techfoundrynz/wheelie_fun_display/pcb/README.md

# PCB designs

Editable board projects and their wiring guides:

- [GUITION 4.3-inch CAN breakout](guition-43/README.md): CAN transceiver, display expansion socket and six-pin vehicle connector.

Mechanical case and mount downloads are in [CAD](../cad/README.md).
