techfoundrynz/wheelie_fun_display/cad/guition-43/rear-casing.step

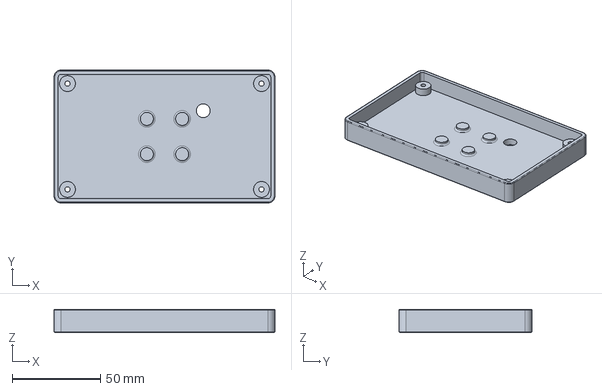
[picture p17: CAD file, 2026-11-12]
cad/guition-43/rear-casing.step
125.3 x 75.3 x 13.2 mm
