techfoundrynz/wheelie_fun_display/cad/waveshare-206/rubber-liner.step

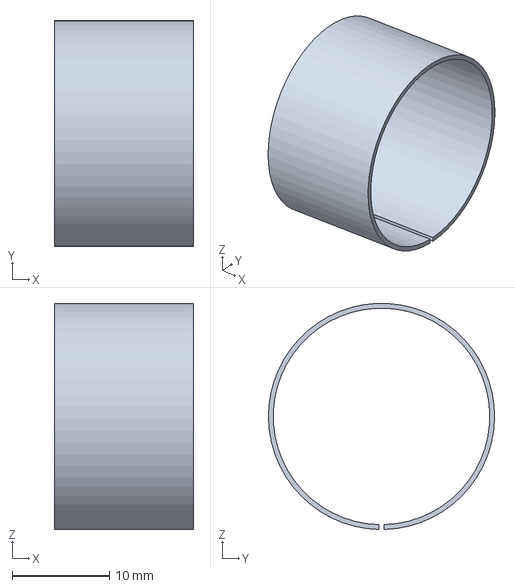
[picture p18: CAD file, 2026-11-08]
cad/waveshare-206/rubber-liner.step
14.3 x 23.2 x 23.2 mm
