techfoundrynz/wheelie_fun_display/cad/guition-43/cable-grommet.step

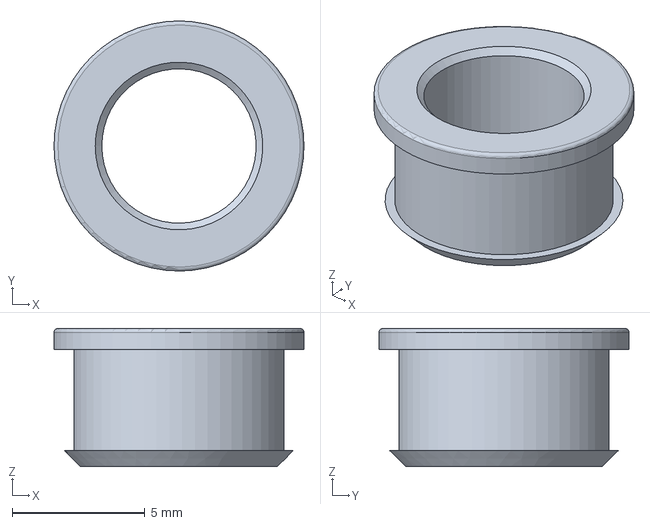
[picture p19: CAD file, 2026-11-12]
cad/guition-43/cable-grommet.step
9.40 x 9.40 x 5.20 mm
