techfoundrynz/wheelie_fun_display/cad/waveshare-206/rear-casing.step

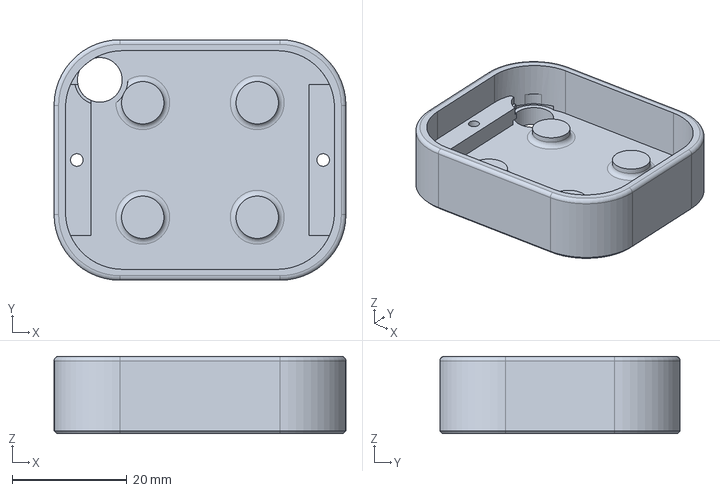
[picture p20: CAD file, 2026-11-08]
cad/waveshare-206/rear-casing.step
51.0 x 42.0 x 13.5 mm
