techfoundrynz/wheelie_fun_display/cad/waveshare-206/upper-saddle.step

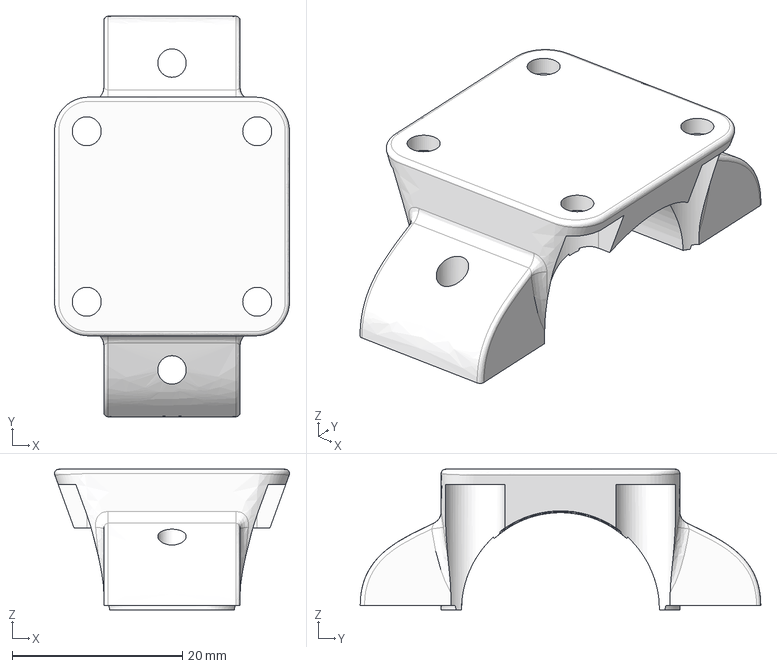
[picture p21: CAD file, 2026-11-08]
cad/waveshare-206/upper-saddle.step
27.6 x 47.0 x 16.5 mm
