techfoundrynz/wheelie_fun_display/cad/guition-43/lower-clamp-cap.step

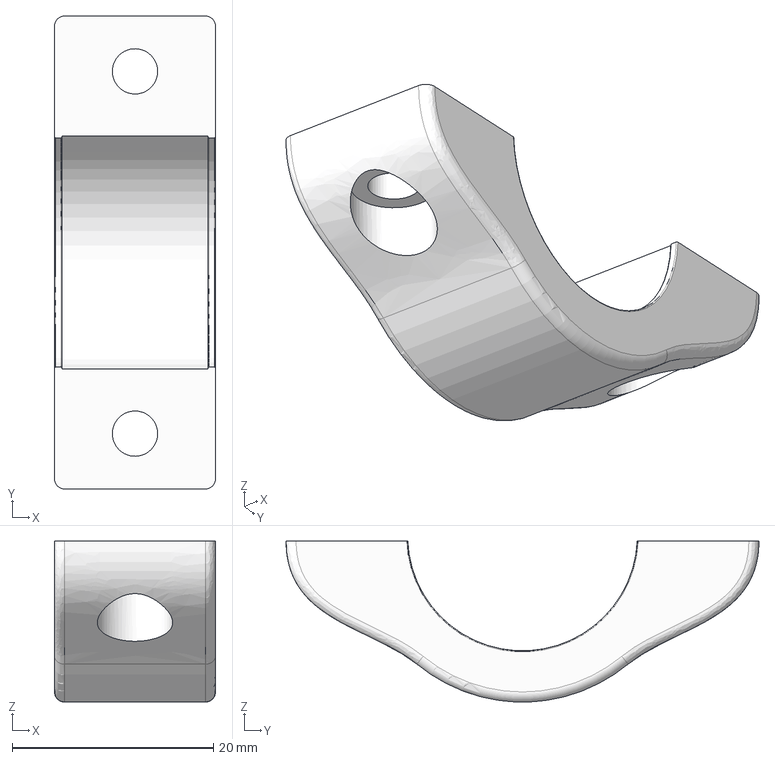
[picture p22: CAD file, 2026-11-08]
cad/guition-43/lower-clamp-cap.step
16.0 x 47.0 x 16.0 mm
