techfoundrynz/wheelie_fun_display/(list of files, cad)

Other CAD files:
cad/guition-43/rubber-liner.step
cad/waveshare-206/lower-clamp-cap.step
cad/guition-43/upper-saddle.step
cad/waveshare-206/cable-grommet.step
cad/wheelie-fun-display-mounts.f3d
