techfoundrynz/wheelie_fun_display/docs/site-maintenance.md

# Releases, validation and Pages

Contributor instructions for publishing firmware and maintaining the help site. For on-device updates, see [updates and maintenance](maintenance.md).

## Automatic releases and PR previews

Increase `[common].custom_firmware_version` in `platformio.ini`, commit and push to `main`. CI compares the configured version with the highest semantic version actually published on GitHub, including prereleases. An unpublished newer version stays eligible on subsequent pushes, so a failed build followed by a formatting or code fix can still release the same version. The first version is eligible when no releases exist. Already published versions, downgrades and build-metadata-only changes do not trigger another release. Draft releases and tags without a published release do not count as publication; failure to query GitHub stops release detection.

The pipeline runs formatting, sanitizer tests and native UI checks, builds every supported `default_envs` target once, then tests the browser simulator and installer using those firmware artifacts. Only after those stages succeed does it create `v<version>` at that commit and publish the OTA/factory images, notices and source references. An existing tag must identify the same commit; published assets are never replaced. Re-running the same published commit leaves its release unchanged.

For an explicit manual publication, run **Actions > CI, firmware and previews > Run workflow** on `main` with **publish_release** enabled. A manual run without that option validates only. Pushed version tags also work, but the tag must match the configuration. Prerelease versions are marked as prereleases on GitHub; separate OTA channels are not implemented.

PRs run the same validation and produce a hosted simulator link and browser-test gallery in one updated bot comment and the publication run summary. Each URL includes the PR number and exact head revision. Preview frames isolate PR scripts from the parent and disable hardware APIs. Superseded builds are skipped, and closing a PR removes its preview and updates the comment.

A separate trusted publisher runs after successful CI, verifies artifact provenance, refreshes only the tested installer's release catalog and firmware files from published releases and deploys Pages. It executes only default-branch publication code, never PR publication scripts. Generated site content is retained on the `gh-pages` storage branch so production updates preserve open PR previews. The first successful `main` pipeline initializes that storage automatically; PR publication cannot replace an uninitialized production site. Downloadable site and firmware artifacts remain available as a fallback.

## Release artifacts

Build the supported environments before packaging:

```sh
pio run
python scripts/check_sdkconfig.py --all
python -m pip install -r requirements-release.txt
python scripts/package_release.py
```

Packaging writes OTA applications `.pio/releases/<environment>.bin`, complete USB images `<environment>-factory.bin`, `manifest.json`, `licenses.zip` and `source-references.json`. The notices archive preserves the project, font, icon and bundled component licenses. Source references record the application repository/commit and pinned Slint tag/commit; local uncommitted changes are marked explicitly. The supported list comes from `default_envs`; removed board images are not carried forward. CI builds that supported list at the configured version and passes the verified artifacts to the release stage.

The complete USB image is merged from the build's actual bootloader, partition-table, OTA initialization and application offsets; it is not interchangeable with an OTA application image. USB installation can reset NVS settings.

Review the version, board identity, sizes and hashes before publishing. App slots are 7 MiB each. A newly booted image is accepted only after initialization and ten seconds of a functioning UI loop; an early failure leaves rollback available.

## Hardware acceptance

A successful build and simulator check do not establish radio or wired interoperability. For a release, record the exact board, controller firmware and phone/app used, then exercise:

- Cold boot, all four orientations, corner-safe layout and touch alignment.
- Settings scrolling, PIN entry, locked timeout and wake-contact consumption.
- Disconnect/reconnect, upstream encrypted pairing and changed/removed local PINs.
- CAN/UART operation with the actual transceiver/wiring and controller discovery.
- Phone proxy behavior, CAN forwarding, MTU differences, sustained traffic and lease release.
- Wi-Fi/OTA success, failure, cancellation and first-boot acceptance.

Track remaining hardware work in [TODO](../TODO.md). Record repeatable performance measurements in [performance notes](performance.md); a startup sample does not establish a sustained frame rate.

## Documentation and Pages

The help site is a TypeScript TanStack Start app. See [help-site development](../website/README.md) for local Vite preview, pnpm setup, Oxlint and Oxfmt. The simulator and flasher are React routes; firmware catalogs, WASM and screenshots remain generated build inputs.

CI builds the browser simulator, renders documentation pictures from that current shared Slint UI, then assembles and tests the site. Screenshots are generated artifacts under `.cache/pages/docs-images`; do not check them in or regenerate them before committing.

To reproduce the complete Pages build locally:

```sh
# Install the Node.js 24 / pnpm documentation app once.
corepack pnpm --dir website install --frozen-lockfile
python -m pip install -r requirements-docs.txt -r simulator/requirements-browser-test.txt
python -m playwright install chromium
python scripts/build_web_simulator.py --output .cache/pages/site/simulator
python scripts/generate_docs_screenshots.py --site .cache/pages/site
python scripts/build_docs.py --output .cache/pages/site
python scripts/build_flash_site.py --site .cache/pages/site --github-release
python tests/flasher_browser_test.py --site .cache/pages/site
python tests/simulator_browser_test.py --site .cache/pages/site
python scripts/package_browser_results.py --site .cache/pages/site
python tests/docs_browser_test.py --site .cache/pages/site
```

The [browser installer](https://techfoundrynz.github.io/wheelie_fun_display/install/) uses pinned ESP Web Tools and same-origin, SHA256-verified release images. After successful CI and any release publication, the trusted Pages publisher refreshes the installer from published images without rebuilding the simulator. Before the first release, the installer lists supported boards and reports that firmware is unavailable. For local packaging checks, use `--release-dir .pio/releases` instead of `--github-release`; that preview is clearly labelled unpublished.

The [interactive simulator](../simulator/) is the clean end-user preview. The separate [CI browser evidence gallery](../ci/) contains touchscreen checks and their captured images. Browser checks cover root and project-subpath hosting, navigation, search, touch, rotation, PIN entry, telemetry and responsive layout. Screenshots support visual review; they are not pixel-baseline comparisons or real-device acceptance.

Preview the generated site through a local HTTP server. Both the downloadable site artifact and GitHub Pages include the simulator and separate CI gallery. Generated HTML and screenshots are build outputs, not a second hand-edited copy of the source.

## Test discovery

TypeScript tests for the help site use Vitest. Add `*.test.ts` or `*.test.tsx` files under `website/src` or `website/plugins`. Run `corepack pnpm test:docs` once, or `corepack pnpm test:docs:watch` while editing. The Pages workflow runs the same Vitest suite before building the site. Browser acceptance checks continue to use Playwright against the built app.

CI runs the same framework entry points used locally:

```sh
python -m unittest discover -s tests -p '*_tests.py' -v
corepack pnpm test:docs
node --test tests/*_tests.cjs
cargo test --locked --manifest-path simulator/Cargo.toml
ctest --test-dir .cache/host-tests --output-on-failure
```

Add Python unit tests as `tests/*_tests.py` and Node suites as `tests/*_tests.cjs`. Cargo automatically discovers `#[test]` cases under `simulator/tests/`; display scenarios share the supported viewport list and launch isolated fixture processes to avoid sharing Slint platform state. Register C++ suites with CTest in `tests/CMakeLists.txt`. New test cases do not require workflow edits. Browser acceptance checks run in the Pages build after its simulator and installer artifacts exist.

The P4 board profile explicitly selects `build.toolchain = riscv32-esp`. A pre-build hook applies it immediately before framework build environments are created, and the matching compiler package is pinned in the common configuration. This compensates for espressif32 8.0.0's incomplete MCU architecture table; do not patch the locally installed platform builder.
