techfoundrynz/wheelie_fun_display/firmware/main/board_guition_p4.cpp

#include "board.hpp"
#include "boards/guition_st7701_init.hpp"
#include "driver/gpio.h"
#include "driver/i2c_master.h"
#include "driver/ledc.h"
#include "eh_host_core.h"
#include "eh_host_mcu_transport.h"
#include "eh_host_mcu_transport_init_event.h"
#include "esp_cache.h"
#include "esp_check.h"
#include "esp_hosted_bt_host_stack.h"
#include "esp_lcd_mipi_dsi.h"
#include "esp_lcd_panel_io.h"
#include "esp_lcd_touch_gt911.h"
#include "esp_ldo_regulator.h"
#include "esp_timer.h"
#include "freertos/task.h"
#include "render_profile.hpp"
#include <algorithm>
#include <atomic>
#include <cstring>

namespace board
{
namespace
{

esp_ldo_channel_handle_t phy_supply;
esp_lcd_dsi_bus_handle_t dsi;
esp_lcd_panel_io_handle_t command_io;
uint16_t *framebuffers[2]{};
unsigned back = 1;
SemaphoreHandle_t refreshed;
std::atomic<uint32_t> refresh_generation{0};
uint32_t submitted_refresh = 0;
bool frame_pending = false;
bool has_frame = false;
int display_core = 0;

static_assert(std::atomic<uint32_t>::is_always_lock_free);

bool brightness_ready = false;

bool IRAM_ATTR refresh_done(esp_lcd_panel_handle_t, esp_lcd_dpi_panel_event_data_t *, void *) {
  refresh_generation.fetch_add(1, std::memory_order_release);
  BaseType_t wake = pdFALSE;
  xSemaphoreGiveFromISR(refreshed, &wake);
  return wake == pdTRUE;
}

void reset_pin(int pin, unsigned low_ms, unsigned settle_ms) {
  gpio_config_t config{};
  config.pin_bit_mask = 1ULL << pin;
  config.mode = GPIO_MODE_OUTPUT;
  ESP_ERROR_CHECK(gpio_config(&config));
  ESP_ERROR_CHECK(gpio_set_level(static_cast<gpio_num_t>(pin), 0));
  vTaskDelay(pdMS_TO_TICKS(low_ms));
  ESP_ERROR_CHECK(gpio_set_level(static_cast<gpio_num_t>(pin), 1));
  vTaskDelay(pdMS_TO_TICKS(settle_ms));
}

void init_brightness() {
  ledc_timer_config_t timer{};
  timer.speed_mode = LEDC_LOW_SPEED_MODE;
  timer.duty_resolution = LEDC_TIMER_10_BIT;
  timer.timer_num = LEDC_TIMER_0;
  timer.freq_hz = 5000;
  timer.clk_cfg = LEDC_AUTO_CLK;
  ESP_ERROR_CHECK(ledc_timer_config(&timer));
  ledc_channel_config_t channel{};
  channel.gpio_num = DISP_BL;
  channel.speed_mode = LEDC_LOW_SPEED_MODE;
  channel.channel = LEDC_CHANNEL_0;
  channel.timer_sel = LEDC_TIMER_0;
  channel.duty = 0;
  ESP_ERROR_CHECK(ledc_channel_config(&channel));
  brightness_ready = true;
}

} // namespace

Display init() {
  display_core = xPortGetCoreID();
  init_brightness();
  Display display;
  refreshed = xSemaphoreCreateBinary();
  configASSERT(refreshed);

  esp_ldo_channel_config_t power{};
  power.chan_id = 3;
  power.voltage_mv = 2500;
  ESP_ERROR_CHECK(esp_ldo_acquire_channel(&power, &phy_supply));

  esp_lcd_dsi_bus_config_t bus{};
  bus.bus_id = 0;
  bus.num_data_lanes = DISP_DSI_LANES;
  bus.phy_clk_src = MIPI_DSI_PHY_PLLREF_CLK_SRC_DEFAULT;
  bus.lane_bit_rate_mbps = DISP_DSI_MBPS;
  ESP_ERROR_CHECK(esp_lcd_new_dsi_bus(&bus, &dsi));
  esp_lcd_dbi_io_config_t control{};
  control.virtual_channel = 0;
  control.lcd_cmd_bits = 8;
  control.lcd_param_bits = 8;
  ESP_ERROR_CHECK(esp_lcd_new_panel_io_dbi(dsi, &control, &command_io));

  esp_lcd_dpi_panel_config_t dpi{};
  dpi.virtual_channel = 0;
  dpi.dpi_clk_src = MIPI_DSI_DPI_CLK_SRC_DEFAULT;
  dpi.dpi_clock_freq_mhz = DISP_DPI_CLOCK_MHZ;
  dpi.in_color_format = LCD_COLOR_FMT_RGB565;
  dpi.out_color_format = LCD_COLOR_FMT_RGB565;
  dpi.num_fbs = 2;
  dpi.video_timing.h_size = panel_width;
  dpi.video_timing.v_size = panel_height;
  dpi.video_timing.hsync_pulse_width = 12;
  dpi.video_timing.hsync_back_porch = 42;
  dpi.video_timing.hsync_front_porch = 42;
  dpi.video_timing.vsync_pulse_width = 2;
  dpi.video_timing.vsync_back_porch = 8;
  dpi.video_timing.vsync_front_porch = 166;
  ESP_ERROR_CHECK(esp_lcd_new_panel_dpi(dsi, &dpi, &display.panel));
  reset_pin(DISP_RST, 20, 120);
  for (const auto &entry : board_p4_panel_init_cmds) {
    ESP_ERROR_CHECK(esp_lcd_panel_io_tx_param(command_io, entry.cmd, entry.data, entry.len));
    if (entry.delay_ms)
      vTaskDelay(pdMS_TO_TICKS(entry.delay_ms));
  }
  void *first_framebuffer = nullptr, *second_framebuffer = nullptr;
  ESP_ERROR_CHECK(esp_lcd_dpi_panel_get_frame_buffer(display.panel, 2, &first_framebuffer, &second_framebuffer));
  framebuffers[0] = static_cast<uint16_t *>(first_framebuffer);
  framebuffers[1] = static_cast<uint16_t *>(second_framebuffer);
  const size_t bytes = size_t(panel_width) * panel_height * sizeof(uint16_t);
  for (auto *framebuffer : framebuffers) {
    std::memset(framebuffer, 0, bytes);
    ESP_ERROR_CHECK(esp_cache_msync(framebuffer, bytes, ESP_CACHE_MSYNC_FLAG_DIR_C2M));
  }
  esp_lcd_dpi_panel_event_callbacks_t callbacks{};
  callbacks.on_frame_buf_complete = refresh_done;
  ESP_ERROR_CHECK(esp_lcd_dpi_panel_register_event_callbacks(display.panel, &callbacks, nullptr));
  ESP_ERROR_CHECK(esp_lcd_panel_init(display.panel));

  i2c_master_bus_config_t i2c_config{};
  i2c_config.i2c_port = I2C_NUM_0;
  i2c_config.sda_io_num = static_cast<gpio_num_t>(I2C_SDA);
  i2c_config.scl_io_num = static_cast<gpio_num_t>(I2C_SCL);
  i2c_config.clk_source = I2C_CLK_SRC_DEFAULT;
  i2c_config.glitch_ignore_cnt = 7;
  i2c_config.flags.enable_internal_pullup = true;
  i2c_master_bus_handle_t i2c;
  ESP_ERROR_CHECK(i2c_new_master_bus(&i2c_config, &i2c));
  reset_pin(TP_RST, 10, 50);
  int address = ESP_LCD_TOUCH_IO_I2C_GT911_ADDRESS;
  if (i2c_master_probe(i2c, address, 100) != ESP_OK)
    address = ESP_LCD_TOUCH_IO_I2C_GT911_ADDRESS_BACKUP;
  ESP_ERROR_CHECK(i2c_master_probe(i2c, address, 100));
  esp_lcd_panel_io_i2c_config_t touch_io{};
  touch_io.dev_addr = address;
  touch_io.control_phase_bytes = 1;
  touch_io.lcd_cmd_bits = 16;
  touch_io.flags.disable_control_phase = true;
  touch_io.scl_speed_hz = 400000;
  esp_lcd_panel_io_handle_t touch_control;
  ESP_ERROR_CHECK(esp_lcd_new_panel_io_i2c(i2c, &touch_io, &touch_control));
  esp_lcd_touch_config_t touch{};
  touch.x_max = panel_width;
  touch.y_max = panel_height;
  touch.rst_gpio_num = GPIO_NUM_NC; // Reset completed before probing the strapped address.
  touch.int_gpio_num = GPIO_NUM_NC;
  ESP_ERROR_CHECK(esp_lcd_touch_new_i2c_gt911(touch_control, &touch, &display.touch));
  brightness(70);
  return display;
}

void brightness(int percent) {
  if (!brightness_ready)
    return;
  ESP_ERROR_CHECK(ledc_set_duty(LEDC_LOW_SPEED_MODE, LEDC_CHANNEL_0, std::clamp(percent, 0, 100) * 1023 / 100));
  ESP_ERROR_CHECK(ledc_update_duty(LEDC_LOW_SPEED_MODE, LEDC_CHANNEL_0));
}

esp_err_t init_radio() {
  ESP_RETURN_ON_ERROR(eh_host_init(nullptr), "radio", "Hosted initialization failed");
  ESP_RETURN_ON_ERROR(eh_host_connect_to_slave(), "radio", "C6 transport unavailable");
  esp_hosted_bt_host_stack_cfg_t config{};
  config.stack = ESP_HOSTED_BT_HOST_STACK_NIMBLE;
  // Before v2.5.2, the companion enables Bluetooth at startup and lacks init/enable RPCs.
  const auto companion_version = eh_host_mcu_transport_get_fw_version();
  config.bring_up_controller = !(companion_version >= 0x00000006 && companion_version < 0x00020502);
  config.controller_ready_timeout_ms = EH_BT_CTRL_DEFAULT_READY_TIMEOUT_MS;
  return esp_hosted_bt_host_stack_setup(&config);
}

bool radio_tx_ready() {
  return eh_host_mcu_transport_is_tx_ready() > 0;
}

esp_err_t wait_frame() {
  // UI and DMA ISR share a core: the next ISR sees the published buffer index.
  configASSERT(xPortGetCoreID() == display_core);
  const TickType_t deadline = xTaskGetTickCount() + pdMS_TO_TICKS(500);
  while (frame_pending && refresh_generation.load(std::memory_order_acquire) == submitted_refresh) {
    if (int32_t(deadline - xTaskGetTickCount()) <= 0)
      return ESP_ERR_TIMEOUT;
    xSemaphoreTake(refreshed, pdMS_TO_TICKS(50));
  }
  frame_pending = false;
  return ESP_OK;
}

esp_err_t acquire_frame(uint16_t **pixels) {
  if (!pixels)
    return ESP_ERR_INVALID_ARG;
#if WFD_RENDER_PROFILE
  const auto started = esp_timer_get_time();
#endif
  ESP_RETURN_ON_ERROR(wait_frame(), "display", "Framebuffer handoff timed out");
#if WFD_RENDER_PROFILE
  render_profile::last_refresh_us = esp_timer_get_time() - started;
#endif
  *pixels = framebuffers[back];
  return ESP_OK;
}

const uint16_t *last_frame() {
  return has_frame ? framebuffers[back ^ 1] : nullptr;
}

esp_err_t present_frame(Display &display, FrameRect region) {
#if WFD_RENDER_PROFILE
  const auto started = esp_timer_get_time();
#endif
  ESP_RETURN_ON_ERROR(esp_lcd_panel_draw_bitmap(display.panel, region.x, region.y, region.x + region.width,
                                                region.y + region.height, framebuffers[back]),
                      "display", "Framebuffer presentation failed");
#if WFD_RENDER_PROFILE
  render_profile::last_submit_us = esp_timer_get_time() - started;
#endif
  submitted_refresh = refresh_generation.load(std::memory_order_acquire);
  frame_pending = true;
  has_frame = true;
  back ^= 1;
  return ESP_OK;
}

} // namespace board
