techfoundrynz/wheelie_fun_display/firmware/main/wired_transport.hpp

#pragma once
#include "transport.hpp"

namespace transport
{

bool wired_update_valid(uint32_t session);

void wired_update_reply(uint8_t peer, uint32_t session, std::span<const uint8_t> payload);

Interface &wired_backend(Kind kind);

bool wired_available(Kind kind);

void wired_proxy_ownership(bool owned, uint32_t epoch);

bool wired_send_proxy_fragment(std::span<const uint8_t> bytes, uint32_t epoch);

bool wired_proxy_drained(uint32_t epoch);

void wired_reset_proxy_link();

} // namespace transport
