techfoundrynz/wheelie_fun_display/tests/transport_tests.cpp

#include "bike/can_bridge.hpp"
#include "bike/can_packet.hpp"
#include "bike/configuration_write.hpp"
#include "bike/controller_discovery.hpp"
#include "bike/security_policy.hpp"
#include <cstdlib>
#include <iostream>
#include <numeric>
#include <vector>
#define CHECK(c)                                                                                                       \
  do {                                                                                                                 \
    if (!(c)) {                                                                                                        \
      std::cerr << __LINE__ << ": " #c "\n";                                                                           \
      std::exit(1);                                                                                                    \
    }                                                                                                                  \
  } while (0)
using Bytes = std::vector<uint8_t>;

Bytes firmware(uint8_t uuid, uint8_t type = 0, uint8_t configs = 1) {
  Bytes bytes{0, 6, 6, 'V', 'E', 'S', 'C', 0};
  for (int i = 0; i < 12; ++i)
    bytes.push_back(uuid + i);
  bytes.insert(bytes.end(), {0, 0, type, configs});
  return bytes;
}

Bytes wfb_sample() {
  Bytes bytes(48);
  bytes[0] = 36;
  bytes[1] = 102;
  bytes[2] = 10;
  bytes[3] = 1;
  return bytes;
}

Bytes wheel_e_info(std::string_view name = "Wheel-E") {
  Bytes bytes(61);
  bytes[0] = 36;
  bytes[1] = 101;
  bytes[2] = 0;
  bytes[3] = 2;
  std::copy_n(name.begin(), std::min<size_t>(name.size(), 20), bytes.begin() + 5);
  bytes[25] = 1;
  bytes[26] = 3;
  bytes[54] = 0x27;
  bytes[55] = 0x10;
  return bytes;
}

Bytes wheel_e_sample() {
  Bytes bytes(28);
  bytes[0] = 36;
  bytes[1] = 101;
  bytes[2] = 33;
  bytes[3] = 1;
  bytes[5] = 0x0a;
  bytes[7] = 2;
  return bytes;
}

Bytes setup_sample() {
  Bytes bytes(56);
  bytes[0] = 47;
  return bytes;
}

void codec_tests() {
  for (size_t size :
       {size_t(1), size_t(6), size_t(7), size_t(255), size_t(256), size_t(259), size_t(260), bike::max_payload}) {
    Bytes payload(size);
    std::iota(payload.begin(), payload.end(), uint8_t(0));
    std::vector<bike::CanFrame> frames;
    CHECK(bike::send_can_packet(payload, 12, 254, true, [&](auto frame) {
      frames.push_back(frame);
      return true;
    }));
    bike::CanReassembler decoder;
    std::span<const uint8_t> result;
    uint64_t now = 1;
    for (auto frame : frames)
      result = decoder.feed(frame, 254, 12, now++);
    CHECK(Bytes(result.begin(), result.end()) == payload);
    CHECK(frames.back().id == ((size <= 6 ? 8u : 7u) << 8 | 254));
    if (size > 6) {
      CHECK(frames.front().data[0] == 0 && frames.front().size == 8);
      auto bad = frames.back();
      bad.data[5] ^= 1;
      for (size_t i = 0; i + 1 < frames.size(); ++i)
        decoder.feed(frames[i], 254, 12, now++);
      CHECK(decoder.feed(bad, 254, 12, now++).empty());
      // Missing/reordered fragments and timeout cannot deliver stale payloads.
      for (size_t i = 1; i < frames.size(); ++i)
        CHECK(decoder.feed(frames[i], 254, 12, now++).empty());
      decoder.feed(frames.front(), 254, 12, 1000);
      for (size_t i = 1; i < frames.size(); ++i)
        CHECK(decoder.feed(frames[i], 254, 12, 1600 + i).empty());
    }
    for (auto frame : frames)
      CHECK(decoder.feed(frame, 253, 12, now++).empty());
    for (auto frame : frames)
      CHECK(decoder.feed(frame, 254, 11, now++).empty());
  }
  const Bytes command{36, 102, 12, 1};
  std::vector<bike::CanFrame> frames;
  CHECK(bike::send_can_packet(command, 254, 5, false, [&](auto frame) {
    frames.push_back(frame);
    return true;
  }));
  CHECK(frames.size() == 1 && frames[0].id == 0x805 && frames[0].data[0] == 254 && frames[0].data[1] == 0);
  CHECK(std::equal(command.begin(), command.end(), frames[0].data.begin() + 2));
  bike::CanReassembler decoder;
  CHECK(decoder.feed(frames[0], 5, 254, 1).empty()); // Requests are never interpreted as replies.
  CHECK(!bike::send_can_packet(command, 255, 5, false, [](auto) { return true; }));
  CHECK(!bike::send_can_packet(command, 5, 5, false, [](auto) { return true; }));
  CHECK(!bike::send_can_packet(Bytes(bike::max_payload + 1), 254, 5, false, [](auto) { return true; }));
  CHECK(!bike::send_can_packet(Bytes(1024), 254, 5, false, [](auto) { return false; }));
}

void bridge_tests() {
  bike::ProxyAuthorization authorization{false, true, 1, 1, 1};
  CHECK(authorization.allows(false, false));
  authorization.pin_required = true;
  CHECK(!authorization.allows(false, false));
  CHECK(!authorization.allows(true, false));
  CHECK(authorization.allows(true, true));
  ++authorization.revision; // New/changed bike PIN immediately rejects the old phone bond.
  CHECK(!authorization.allows(true, true));
  authorization.applied_revision = authorization.revision;
  CHECK(!authorization.allows(true, true)); // A previously encrypted connection is still stale.
  authorization.connection_revision = authorization.revision;
  CHECK(authorization.allows(true, true));
  authorization.pin_known = false; // Boot with hashed PIN: user must unlock before BLE can use that PIN.
  CHECK(!authorization.allows(true, true));
  authorization.pin_known = true;
  authorization.pin_required = false;
  ++authorization.revision;
  authorization.applied_revision = authorization.revision;
  CHECK(!authorization.allows(true, true)); // Removing a PIN also invalidates the old connection.
  authorization.connection_revision = authorization.revision;
  CHECK(authorization.allows(false, false));
  CHECK(bike::valid_proxy_name("WB Disp"));
  CHECK(!bike::valid_proxy_name(""));
  CHECK(!bike::valid_proxy_name("bad\nname"));
  CHECK(!bike::valid_proxy_name(std::string(30, 'x')));
  const Bytes forward{34, 42, 36, 101, 12, 1};
  const auto request = bike::can_bridge_request(forward, 254);
  CHECK(request.operation == bike::BridgeOperation::Forward && request.destination == 42);
  CHECK(Bytes(request.payload.begin(), request.payload.end()) == Bytes({36, 101, 12, 1}));
  for (const uint8_t opcode : {0, 157}) {
    const Bytes directed{34, 42, opcode};
    const auto forwarded = bike::can_bridge_request(directed, 254);
    CHECK(forwarded.operation == bike::BridgeOperation::Forward && forwarded.destination == 42);
    CHECK(forwarded.payload.size() == 1 && forwarded.payload[0] == opcode);
  }
  CHECK(bike::can_bridge_request(Bytes{0}, 254).operation == bike::BridgeOperation::Firmware);
  CHECK(bike::can_bridge_request(Bytes{62}, 254).operation == bike::BridgeOperation::Scan);
  CHECK(bike::can_bridge_request(Bytes{47}, 254).operation == bike::BridgeOperation::Unsupported);
  CHECK(bike::can_bridge_request(Bytes{34, 254, 0}, 254).operation == bike::BridgeOperation::Unsupported);
  CHECK(bike::can_bridge_request(Bytes{34, 255, 0}, 254).operation == bike::BridgeOperation::Unsupported);
  CHECK(bike::can_bridge_request({}, 254).operation == bike::BridgeOperation::Unsupported);
  CHECK(bike::can_bridge_request(Bytes{34, 42}, 254).operation == bike::BridgeOperation::Unsupported);
  std::array<uint8_t, 12> uuid{};
  std::array<uint8_t, 96> firmware{};
  const auto length = bike::can_bridge_firmware(firmware, uuid);
  CHECK(length > 30 && firmware[0] == 0);
  const auto end = std::find(firmware.begin() + 3, firmware.end(), 0);
  const auto extra = size_t(end - firmware.begin()) + 13;
  CHECK(firmware[extra + 2] == 2 && firmware[extra + 3] == 0); // Generic adapter, no motor/package identity.
  CHECK(bike::can_bridge_firmware(std::span(firmware).first(10), uuid) == 0);
  const auto branded_length = bike::can_bridge_firmware(firmware, uuid, "waveshare_esp32s3_206", "0.1.3");
  CHECK(branded_length > 0);
  size_t position = 3;
  auto string_at = [&](std::span<const uint8_t> data) {
    const auto first = position;
    while (position < data.size() && data[position])
      ++position;
    CHECK(position < data.size());
    const std::string value(reinterpret_cast<const char *>(data.data() + first), position - first);
    ++position;
    return value;
  };
  const auto identity = std::span(firmware).first(branded_length);
  CHECK(identity[1] == bike::bridge_protocol_major && identity[2] == bike::bridge_protocol_minor);
  CHECK(string_at(identity) == "waveshare_esp32s3_206");
  CHECK(std::equal(uuid.begin(), uuid.end(), identity.begin() + position));
  position += uuid.size();
  CHECK(identity[position++] == 0 && identity[position++] == 0);
  CHECK(identity[position++] == 2);
  for (int flag = 0; flag < 5; ++flag)
    CHECK(identity[position++] == 0);
  CHECK(string_at(identity) == "Wheelie Fun Display v0.1.3");
  CHECK(position + 4 == branded_length);
  CHECK(bike::can_bridge_request(Bytes{157}, 254).operation == bike::BridgeOperation::FirmwareInfo);
  CHECK(bike::can_bridge_request(Bytes{30}, 254).operation == bike::BridgeOperation::Ignore);
  std::array<uint8_t, 128> info{};
  auto info_length = bike::can_bridge_firmware_info(info, "0123456789abcdef-dirty", "");
  CHECK(info_length == 28 && info[0] == 157 && info[1] == bike::bridge_protocol_major &&
        info[2] == bike::bridge_protocol_minor && info[3] == 0);
  position = 4;
  CHECK(string_at(std::span(info).first(info_length)) == "0123456789abcdef-dirty");
  CHECK(string_at(std::span(info).first(info_length)).empty() && position == info_length);
  CHECK(bike::can_bridge_firmware_info(std::span(info).first(info_length - 1), "0123456789abcdef-dirty") == 0);
  info_length = bike::can_bridge_firmware_info(info, std::string(90, 'a'), std::string(90, 'b'));
  CHECK(info_length == 98 && info[50] == 0 && info[97] == 0);
  CHECK(bike::can_bridge_firmware_info(info, "") == 6);

  for (const bool extended : {false, true}) {
    const uint32_t identifier = extended ? 0x1fffffffu : 0x7ffu;
    Bytes raw{85,
              uint8_t(identifier >> 24),
              uint8_t(identifier >> 16),
              uint8_t(identifier >> 8),
              uint8_t(identifier),
              uint8_t(extended)};
    for (unsigned dlc = 0; dlc <= 8; ++dlc) {
      const auto parsed = bike::can_bridge_request(raw, 254);
      CHECK(parsed.operation == bike::BridgeOperation::RawFrame);
      CHECK(parsed.frame.id == identifier && parsed.frame.extended == extended && !parsed.frame.remote);
      CHECK(parsed.frame.size == dlc);
      CHECK(std::equal(raw.begin() + 6, raw.end(), parsed.frame.data.begin()));
      CHECK(bike::valid_can_data_frame(parsed.frame));
      raw.push_back(uint8_t(dlc));
    }
    CHECK(bike::can_bridge_request(raw, 254).operation == bike::BridgeOperation::Invalid);
  }
  for (const Bytes &malformed : {Bytes{85}, Bytes{85, 0, 0, 0, 0}, Bytes{85, 0, 0, 0, 0, 2}, Bytes{85, 0, 0, 8, 0, 0},
                                 Bytes{85, 0x20, 0, 0, 0, 1}})
    CHECK(bike::can_bridge_request(malformed, 254).operation == bike::BridgeOperation::Invalid);
  bike::CanFrame invalid;
  invalid.remote = true;
  CHECK(!bike::valid_can_data_frame(invalid));
  invalid.remote = false;
  invalid.size = 9;
  CHECK(!bike::valid_can_data_frame(invalid));
  std::vector<bike::CanFrame> frames;
  CHECK(bike::send_can_packet(Bytes{0, 6, 6}, 42, 254, true, [&](auto frame) {
    frames.push_back(frame);
    return true;
  }));
  bike::CanReassembler decoder;
  const auto payload = decoder.feed(frames.front(), 254, -1, 1);
  CHECK(Bytes(payload.begin(), payload.end()) == Bytes({0, 6, 6}) && decoder.sender() == 42);
}

void discovery_tests() {
  bike::ControllerDiscovery discovery;
  bike::DiscoveryRequest request;
  discovery.start(false, bike::IntegrationId::Wfb, 0);
  CHECK(discovery.next(0, request) && request.scan && request.bytes[0] == 62);
  const Bytes scan{62, 1, 2, 3};
  discovery.feed(scan, -2, 1);
  CHECK(discovery.next(151, request) && request.route == -1 && request.bytes[0] == 0);
  discovery.feed(firmware(1, 0, 0), -2, 152);
  CHECK(discovery.next(302, request) && request.bytes[0] == 36);
  // Direct controller has no matching package; move to the CAN candidates.
  CHECK(!discovery.next(953, request));
  CHECK(discovery.next(1103, request) && request.route == 1);
  discovery.feed(firmware(2, 1), -2, 1104); // BMS: skip without package writes/probes.
  CHECK(discovery.next(1254, request) && request.route == 2);
  discovery.feed(firmware(3), -2, 1255);
  CHECK(discovery.next(1405, request) && request.route == 2 && request.bytes[1] == 102);
  discovery.feed(wfb_sample(), -2, 1406);
  CHECK(discovery.complete() && discovery.chosen() >= 0);
  CHECK(discovery.controller(discovery.chosen()).route == 2);
  CHECK(!discovery.next(9999, request)); // First verified package wins, with no user prompt.

  discovery.start(true, bike::IntegrationId::Wfb, 0);
  CHECK(discovery.next(0, request) && request.scan);
  const uint8_t ids[]{3, 4};
  discovery.scanned(ids, false, 1);
  CHECK(discovery.next(151, request) && request.route == 3);
  discovery.feed(firmware(3), 4, 152); // Native CAN reply from another controller is ignored.
  CHECK(!discovery.next(200, request));
  discovery.feed(firmware(3), 3, 201);
  CHECK(discovery.next(351, request));
  discovery.feed(wfb_sample(), 3, 352);
  CHECK(discovery.complete() && discovery.controller(discovery.chosen()).route == 3);

  discovery.start(true, bike::IntegrationId::Vesc, 0);
  discovery.scanned(ids, false, 1);
  CHECK(discovery.next(151, request));
  discovery.feed(firmware(3, 0, 0), 3, 152);
  CHECK(discovery.next(302, request) && request.bytes[0] == 47);
  discovery.feed(setup_sample(), 3, 303);
  CHECK(!discovery.complete()); // Prefer an installed custom package over a plain motor controller.
  CHECK(discovery.next(453, request) && request.route == 4);
  discovery.feed(firmware(4), 4, 454);
  CHECK(discovery.next(604, request));
  discovery.feed(setup_sample(), 4, 605);
  CHECK(discovery.complete() && discovery.controller(discovery.chosen()).route == 4);

  discovery.start(false, bike::IntegrationId::Wfb, 0);
  CHECK(discovery.next(0, request));
  CHECK(!discovery.next(7150, request));
  CHECK(discovery.next(7300, request) && request.route == -1); // CAN ping timeout still probes the direct controller.
  discovery.feed(Bytes{0, 6, 6, 'N', 'O'}, -2, 7301);          // Unterminated/truncated firmware identity is rejected.
  CHECK(!discovery.next(7951, request));
  CHECK(discovery.complete() && discovery.chosen() < 0);
  discovery.start(true, bike::IntegrationId::Wfb, 0);
  discovery.scanned({}, false, 1);
  CHECK(discovery.complete() && discovery.chosen() < 0); // Reconnect discards earlier identity/route.
}

void auto_discovery_tests() {
  bike::ControllerDiscovery discovery;
  bike::DiscoveryRequest request;
  CHECK(bike::integration_id(-1) == bike::IntegrationId::Auto);
  CHECK(bike::integration_id(255) == bike::IntegrationId::Auto);
  CHECK(!bike::integration(bike::IntegrationId::Auto).features().lock);

  auto direct = [&] {
    discovery.start(false, bike::IntegrationId::Auto, 0);
    CHECK(discovery.next(0, request) && request.scan);
    discovery.feed(Bytes{62}, -2, 1);
    CHECK(discovery.next(151, request) && request.bytes[0] == 0);
    discovery.feed(firmware(1), -2, 152);
    CHECK(discovery.next(302, request) && request.bytes[0] == 36 && request.bytes[1] == 102);
  };
  direct();
  // Neither a firmware custom-config flag nor standard telemetry proves a WFB package.
  discovery.feed(setup_sample(), -2, 303);
  discovery.feed(wheel_e_sample(), -2, 304); // A reply for a probe not sent yet is ignored.
  CHECK(!discovery.complete());
  CHECK(!discovery.next(953, request));
  CHECK(discovery.next(1103, request) && request.bytes[1] == 101 && request.bytes[2] == 0);
  discovery.feed(wheel_e_sample(), -2, 1104);
  CHECK(!discovery.complete());
  discovery.feed(wheel_e_info(), -2, 1105);
  CHECK(discovery.next(1255, request) && request.bytes[2] == 33);
  auto malformed = wheel_e_sample();
  malformed[7] = 0;
  discovery.feed(malformed, -2, 1256);
  CHECK(!discovery.complete());
  discovery.feed(wheel_e_sample(), -2, 1257);
  CHECK(discovery.complete() && discovery.chosen() >= 0);
  CHECK(discovery.controller(discovery.chosen()).integration == bike::IntegrationId::WheelE);
  CHECK(discovery.selection() == bike::IntegrationId::Auto); // Keep re-probing policy independent of detected package.

  direct(); // A reconnect must probe again rather than restore a detected package as a manual choice.
  discovery.feed(wfb_sample(), -2, 303);
  CHECK(discovery.complete() && discovery.controller(discovery.chosen()).integration == bike::IntegrationId::Wfb);

  direct();
  CHECK(!discovery.next(953, request));
  CHECK(discovery.next(1103, request) && request.bytes[1] == 101);
  CHECK(!discovery.next(1754, request));
  CHECK(discovery.next(1904, request) && request.bytes[0] == 47);
  discovery.feed(setup_sample(), -2, 1905);
  CHECK(discovery.complete() && discovery.controller(discovery.chosen()).integration == bike::IntegrationId::Vesc);
  CHECK(!bike::integration(discovery.controller(discovery.chosen()).integration).features().lock);

  direct();
  CHECK(!discovery.next(953, request));
  CHECK(discovery.next(1103, request));
  CHECK(!discovery.next(1754, request));
  CHECK(discovery.next(1904, request));
  CHECK(!discovery.next(2555, request));
  CHECK(discovery.complete() && discovery.chosen() < 0); // No valid package or VESC telemetry: no ready controller.

  // Auto must continue beyond an unrelated custom configuration to the first known package.
  discovery.start(true, bike::IntegrationId::Auto, 0);
  const uint8_t ids[]{3, 4};
  discovery.scanned(ids, false, 1);
  CHECK(discovery.next(151, request) && request.route == 3);
  discovery.feed(firmware(3), 3, 152);
  CHECK(discovery.next(302, request));
  CHECK(!discovery.next(953, request));
  CHECK(discovery.next(1103, request));
  CHECK(!discovery.next(1754, request));
  CHECK(discovery.next(1904, request) && request.bytes[0] == 47);
  discovery.feed(setup_sample(), 3, 1905);
  CHECK(!discovery.complete());
  CHECK(discovery.next(2055, request) && request.route == 4);
  discovery.feed(firmware(4), 4, 2056);
  CHECK(discovery.next(2206, request) && request.bytes[1] == 102);
  discovery.feed(wfb_sample(), 4, 2207);
  CHECK(discovery.complete() && discovery.controller(discovery.chosen()).route == 4);
  CHECK(discovery.controller(discovery.chosen()).integration == bike::IntegrationId::Wfb);

  // The same controller may be reachable directly and over CAN. Prefer the
  // route that verified its custom package over an earlier generic-only path.
  discovery.start(false, bike::IntegrationId::Auto, 0);
  CHECK(discovery.next(0, request) && request.scan);
  discovery.feed(Bytes{62, 7}, -2, 1);
  CHECK(discovery.next(151, request));
  discovery.feed(firmware(9), -2, 152);
  CHECK(discovery.next(302, request));
  CHECK(!discovery.next(953, request));
  CHECK(discovery.next(1103, request));
  CHECK(!discovery.next(1754, request));
  CHECK(discovery.next(1904, request));
  discovery.feed(setup_sample(), -2, 1905);
  CHECK(discovery.next(2055, request) && request.route == 7);
  discovery.feed(firmware(9), -2, 2056);
  CHECK(discovery.next(2206, request));
  discovery.feed(wfb_sample(), -2, 2207);
  CHECK(discovery.complete() && discovery.controller(discovery.chosen()).route == 7);
  CHECK(discovery.controller(discovery.chosen()).integration == bike::IntegrationId::Wfb);
  CHECK(discovery.controller(0).duplicate);

  discovery.start(false, bike::IntegrationId::Wfb, 0);
  CHECK(discovery.next(0, request) && request.scan);
  discovery.feed(Bytes{62}, -2, 1);
  CHECK(discovery.next(151, request));
  discovery.feed(firmware(1), -2, 152);
  CHECK(discovery.next(302, request));
  discovery.feed(wheel_e_sample(), -2, 303);
  CHECK(!discovery.next(953, request));
  CHECK(discovery.complete() && discovery.chosen() < 0); // Explicit selections never switch packages or fall back.
}

bike::ControllerHint hint_for(int route, uint8_t uuid, bike::IntegrationId verified = bike::IntegrationId::Auto) {
  bike::ControllerHint hint;
  hint.route = route;
  hint.integration = verified;
  for (size_t i = 0; i < hint.uuid.size(); ++i)
    hint.uuid[i] = uint8_t(uuid + i);
  return hint;
}

void hint_codec_tests() {
  bike::HintRecord record{{0, bike::IntegrationId::Auto, {1, 2, 3, 4, 5, 6, 7}}, hint_for(7, 1)};
  const auto bytes = bike::encode_hint(record);
  auto decoded = bike::decode_hint(bytes);
  CHECK(decoded && decoded->context == record.context && decoded->controller == record.controller);
  for (size_t size = 0; size < bytes.size(); ++size)
    CHECK(!bike::decode_hint(std::span(bytes).first(size)));
  Bytes extra(bytes.begin(), bytes.end());
  extra.push_back(0);
  CHECK(!bike::decode_hint(extra));
  for (auto [position, value] : {std::pair<size_t, uint8_t>{0, 3}, {1, 3}, {2, 3}, {3, 4}, {23, 3}}) {
    auto corrupt = bytes;
    corrupt[position] = value;
    CHECK(!bike::decode_hint(corrupt));
  }
  auto other = record.context;
  other.peer[6] ^= 1;
  CHECK(other != record.context);
  other = record.context;
  other.selection = bike::IntegrationId::Wfb;
  CHECK(other != record.context);
  for (int route : {-2, 255}) {
    auto invalid = record;
    invalid.controller.route = route;
    CHECK(!bike::valid_hint(invalid) && !bike::decode_hint(bike::encode_hint(invalid)));
  }
  for (uint8_t fill : {uint8_t(0), uint8_t(255)}) {
    auto invalid = record;
    invalid.controller.uuid.fill(fill);
    CHECK(!bike::valid_hint(invalid));
  }
  auto empty_peer = record;
  empty_peer.context.peer.fill(0);
  CHECK(!bike::valid_hint(empty_peer));
  auto can = record;
  can.context.transport = 1;
  CHECK(!bike::valid_hint(can)); // A wired hint must not carry a stale BLE association.
  can.context.peer.fill(0);
  can.controller.route = -1;
  CHECK(!bike::valid_hint(can));
  can.controller.route = 0;
  CHECK(bike::decode_hint(bike::encode_hint(can)));
  auto corrupt_can = bike::encode_hint(can);
  corrupt_can[10] = 0;
  CHECK(!bike::decode_hint(corrupt_can));
  corrupt_can = bike::encode_hint(can);
  corrupt_can[3] = 1;
  CHECK(!bike::decode_hint(corrupt_can));
  auto uart = can;
  uart.context.transport = 2;
  uart.controller.route = -1;
  CHECK(bike::decode_hint(bike::encode_hint(uart)));

  // Version 1 persisted only route and UUID. Keep those hints usable without
  // treating a missing package field as a verified generic VESC integration.
  Bytes legacy(bytes.begin(), bytes.begin() + 23);
  legacy[0] = 1;
  decoded = bike::decode_hint(legacy);
  CHECK(decoded && decoded->controller == record.controller);
  legacy.push_back(0);
  CHECK(!bike::decode_hint(legacy));

  record.controller.integration = bike::IntegrationId::WheelE;
  decoded = bike::decode_hint(bike::encode_hint(record));
  CHECK(decoded && decoded->controller == record.controller);
  record.context.selection = bike::IntegrationId::Wfb;
  CHECK(!bike::valid_hint(record)); // An explicit selection cannot inherit another package.
}

void remembered_package_discovery_tests() {
  using Id = bike::IntegrationId;
  bike::ControllerDiscovery discovery;
  bike::DiscoveryRequest request;
  for (bool native : {false, true}) {
    const int route = native ? 7 : -1;
    for (Id verified : {Id::Wfb, Id::WheelE}) {
      discovery.start(native, Id::Auto, 0, hint_for(route, 7, verified));
      CHECK(discovery.using_hint() && !discovery.complete());
      CHECK(discovery.next(150, request) && !request.scan && request.route == route && request.bytes[0] == 0);
      discovery.feed(firmware(7), route, 151);
      CHECK(!discovery.complete()); // A matching cached UUID is not live package verification.
      CHECK(discovery.next(301, request) && !request.scan);
      if (verified == Id::WheelE) {
        CHECK(request.bytes[1] == 101 && request.bytes[2] == 0); // No WFB timeout on a known wheel-e bike.
        discovery.feed(wheel_e_sample(), route, 302);
        CHECK(!discovery.complete()); // Cached package names cannot replace INFO verification.
        discovery.feed(wheel_e_info(), route, 303);
        CHECK(discovery.next(453, request) && !request.scan && request.bytes[2] == 33);
        discovery.feed(wheel_e_sample(), route, 454);
      }
      else {
        CHECK(request.bytes[1] == 102);
        discovery.feed(wfb_sample(), route, 302);
      }
      CHECK(discovery.complete() && discovery.chosen() == 0 && discovery.count() == 1);
      CHECK(discovery.controller(0).integration == verified);
      CHECK(!discovery.next(500, request)); // A valid remembered package never requests a CAN scan.
    }
  }

  // Removing the cached package must fall back to normal discovery rather than
  // silently accepting generic telemetry and concealing another package route.
  discovery.start(true, Id::Auto, 0, hint_for(7, 7, Id::WheelE));
  CHECK(discovery.next(150, request));
  discovery.feed(firmware(7), 7, 151);
  CHECK(discovery.next(301, request) && request.bytes[2] == 0);
  discovery.feed(wheel_e_info("Refloat"), 7, 302);
  CHECK(!discovery.next(952, request));
  CHECK(!discovery.using_hint());
  CHECK(discovery.next(953, request) && request.scan);

  // Reusing the CAN address for another controller invalidates the remembered
  // route even if that replacement advertises the same package.
  discovery.start(true, Id::Auto, 0, hint_for(7, 7, Id::WheelE));
  CHECK(discovery.next(150, request));
  discovery.feed(firmware(8), 7, 151);
  CHECK(!discovery.using_hint() && !discovery.complete());
  CHECK(discovery.next(152, request) && request.scan);

  // A generic cache cannot conceal a package on a different CAN controller.
  discovery.start(true, Id::Auto, 0, hint_for(7, 7, Id::Vesc));
  CHECK(discovery.next(150, request));
  discovery.feed(firmware(7), 7, 151);
  CHECK(discovery.next(301, request) && request.bytes[1] == 102);
  discovery.feed(setup_sample(), 7, 302);
  CHECK(!discovery.complete() && !discovery.next(952, request));
  CHECK(discovery.next(953, request) && request.scan);

  // A changed explicit selection takes precedence over any cached package.
  discovery.start(true, Id::Wfb, 0, hint_for(7, 7, Id::WheelE));
  CHECK(discovery.next(150, request));
  discovery.feed(firmware(7), 7, 151);
  CHECK(discovery.next(301, request) && request.bytes[1] == 102);
  discovery.feed(wheel_e_info(), 7, 302);
  discovery.feed(wheel_e_sample(), 7, 303);
  CHECK(!discovery.complete());

  // Each connection re-verifies the package; a prior completed session is not
  // sufficient when the new session has not answered the firmware query.
  discovery.start(true, Id::Auto, 0, hint_for(7, 7, Id::WheelE));
  CHECK(discovery.next(150, request));
  CHECK(!discovery.complete() && !discovery.next(801, request));
  CHECK(discovery.next(802, request) && request.scan);
}

void cached_discovery_tests() {
  bike::ControllerDiscovery discovery;
  bike::DiscoveryRequest request;
  const auto hint = hint_for(7, 7);
  auto begin = [&](bike::IntegrationId choice) {
    discovery.start(true, choice, 0, hint);
    CHECK(!discovery.next(0, request));
    CHECK(discovery.next(150, request) && !request.scan && request.route == 7 && request.bytes[0] == 0);
    CHECK(!discovery.complete()); // A cached identity alone never makes the link ready.
    discovery.feed(firmware(7, 0, 0), 7, 151);
    CHECK(!discovery.complete());
    CHECK(discovery.next(301, request));
  };
  begin(bike::IntegrationId::Auto);
  CHECK(request.bytes[1] == 102);
  discovery.feed(wfb_sample(), 7, 302);
  CHECK(discovery.complete() && discovery.controller(discovery.chosen()).route == 7);
  CHECK(discovery.controller(discovery.chosen()).integration == bike::IntegrationId::Wfb);
  CHECK(discovery.selection() == bike::IntegrationId::Auto);

  begin(bike::IntegrationId::WheelE);
  CHECK(request.bytes[1] == 101 && request.bytes[2] == 0);
  discovery.feed(wfb_sample(), 7, 302);
  CHECK(!discovery.complete());
  discovery.feed(wheel_e_info(), 7, 303);
  CHECK(!discovery.complete());
  CHECK(discovery.next(453, request) && request.bytes[2] == 33);
  discovery.feed(wheel_e_sample(), 7, 454);
  CHECK(discovery.complete() && discovery.controller(discovery.chosen()).integration == bike::IntegrationId::WheelE);

  begin(bike::IntegrationId::Vesc);
  CHECK(request.bytes[0] == 47);
  discovery.feed(setup_sample(), 7, 302);
  CHECK(discovery.complete() && discovery.controller(discovery.chosen()).integration == bike::IntegrationId::Vesc);

  // Same route on a different vehicle is not a cache hit: UUID is mandatory.
  discovery.start(true, bike::IntegrationId::Wfb, 0, hint);
  CHECK(discovery.next(150, request) && request.route == 7);
  discovery.feed(firmware(8), 7, 151);
  CHECK(!discovery.complete() && !discovery.awaiting_scan());
  CHECK(discovery.next(152, request) && request.scan && discovery.awaiting_scan());
  const uint8_t ids[]{9};
  discovery.scanned(ids, false, 153);
  CHECK(discovery.next(303, request) && request.route == 9 && request.bytes[0] == 0);
  discovery.feed(firmware(9), 9, 304);
  CHECK(discovery.next(454, request) && request.bytes[1] == 102);
  discovery.feed(wfb_sample(), 9, 455);
  CHECK(discovery.complete() && discovery.controller(discovery.chosen()).route == 9);

  begin(bike::IntegrationId::Wfb);
  discovery.feed(wheel_e_sample(), 7, 302);
  CHECK(!discovery.complete());
  CHECK(!discovery.next(952, request));
  CHECK(discovery.next(953, request) && request.scan); // Wrong or removed package triggers full discovery.

  // Auto cannot use a generic-only cache hit to hide another controller's custom package.
  begin(bike::IntegrationId::Auto);
  CHECK(!discovery.next(952, request));
  CHECK(discovery.next(1102, request) && request.bytes[1] == 101);
  CHECK(!discovery.next(1753, request));
  CHECK(discovery.next(1903, request) && request.bytes[0] == 47);
  discovery.feed(setup_sample(), 7, 1904);
  CHECK(!discovery.complete());
  CHECK(discovery.next(1905, request) && request.scan);
  discovery.scanned(ids, false, 1906);
  CHECK(discovery.next(2056, request) && request.route == 9);
  discovery.feed(firmware(9), 9, 2057);
  CHECK(discovery.next(2207, request));
  discovery.feed(wfb_sample(), 9, 2208);
  CHECK(discovery.complete() && discovery.controller(discovery.chosen()).route == 9);

  discovery.start(true, bike::IntegrationId::Wfb, 0, hint);
  CHECK(discovery.next(150, request));
  CHECK(!discovery.next(801, request));
  CHECK(discovery.next(802, request) && request.scan); // A disappeared cached CAN ID cannot stall discovery.
}
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
