techfoundrynz/wheelie_fun_display/(commit log)

2026-11-06 Initial commit of project
    [partitions.csv]
2026-11-07 Add trip and ODO Improve pin enter Fix BLE passthrough Rearrange UI Fix stat parsing
    [ble.cpp, ble.hpp, ble_lifecycle_tests.cpp, ble_proxy.cpp, ble_proxy.hpp, ble_signal.hpp, build.rs, build_docs.py]
2026-11-07 Fix release build redetection
    [release_version.py, release_version_tests.py]
2026-11-07 Add waveshare case
    [lower-clamp-cap.step, rear-casing.step, rubber-liner.step, upper-saddle.step, wheelie-fun-display-waveshare-206.f3d]
2026-11-07 Allow cad files
2026-11-07 Update waveshare CAD
    [lower-clamp-cap.step, rear-casing.step, rubber-liner.step, upper-saddle.step, wheelie-fun-display-waveshare-206.f3d]
2026-11-07 Update tuning base on current app ui
2026-11-07 Update waveshare cad with cable seal/grommet Add commands for VESC Tool firmware updates and CAN reporting Improve OTA UI
    [cable-grommet.step, lower-clamp-cap.step, rear-casing.step, rubber-liner.step, upper-saddle.step, wheelie-fun-display-waveshare-206.f3d]
2026-11-08 Add guition cad
    [cable-grommet.step, lower-clamp-cap.step, rear-casing.step, rubber-liner.step, upper-saddle.step, wheelie-fun-display-mounts.f3d, wheelie-fun-display-waveshare-206.f3d]
2026-11-08 Add guition PCB breakout
2026-11-10 Add AI assistants section and fix bugs
    [docs_browser_test.py]
2026-11-12 Finish guition support Fix battery % reporting Improve FPS
    [cable-grommet.step, rear-casing.step, wheelie-fun-display-mounts.f3d]
